vanceb/xbee-sensor/README.md

# xbee-sensor
Solar/battery powered sensor that uses XBee radios for communication
