vanceb/xbee-sensor/kicad/xbee-sensor_V2.0_BOM.ods

Id | Designator | Package | Quantity | Designation | In Stock
1 | C1,C2 | C_0805_2012Metric | 2 | 4.7uF | Y
2 | C3,C7,C8,C9 | C_0603_1608Metric | 4 | 100nF | Y
3 | C4,C12 | C_0805_2012Metric | 2 | 10uF | Y
4 | C5,C6 | C_0805_2012Metric | 2 | 1uF | Y
5 | C10,C11 | C_0402_1005Metric | 2 | 10pF | Y
6 | D1,D2,D3,D4,D5,D6,D7 | LED_0603_1608Metric | 7 | LED | Y
7 | J1 | PinHeader_1x02_P2.54mm_Vertical | 1 | Solar | Y
8 | J2 | PinHeader_2x03_P2.54mm_Vertical | 1 | SWD | Y
9 | J3 | PinHeader_1x04_P2.54mm_Vertical | 1 | I2C | Y
10 | J4 | JST_PH_S2B-PH-K_1x02_P2.00mm_Horizontal | 1 | Battery | Y
11 | J5 | PinHeader_1x03_P2.54mm_Vertical | 1 | PIR | Y
12 | Q1,Q2 | SOT-23 | 2 | NX2301P | Y
13 | Q3 | SOT-23 | 1 | SI2333DDS | Y
14 | R1,R2,R4,R5 | R_0603_1608Metric | 4 | 100k | Y
15 | R3 | R_0603_1608Metric | 1 | 2k | Y
16 | R6,R7 | R_0603_1608Metric | 2 | 10k | Y
17 | R8,R9,R10,R11,R12,R13,R14 | R_0603_1608Metric | 7 | 1k | Y
18 | U1 | SOT-223-3_TabPin2 | 1 | LD1117S33TR_SOT223 | Y
19 | U2 | SOT-23-5 | 1 | MCP73831-2-OT | 3
20 | U3 | XBee | 1 | XBee_Module_TH | 3
21 | U4 | LQFP-32_7x7mm_P0.8mm | 1 | STM32L031K6Tx | 3
22 | U5 | Allegro_SIP-3 | 1 | A3213 | 3
23 | Y1 | Crystal_SMD_3215-2Pin_3.2x1.5mm | 1 | Crystal | 3
24 | REF**,REF**,REF**,REF** | MountingHole_3.2mm_M3_ISO14580 | 4 | MountingHole_3.2mm_M3_ISO14580
25 | JP1 | PinHeader_1x02_P2.54mm_Vertical | 1 | LED_EN | Y
