vanceb/xbee-sensor/kicad/xbee-sensor-bom.ods

Item | Qty | Reference(s) | Value | LibPart
1 | 2 | C1, C2 | 4.7uF | Device:C
2 | 4 | C3, C7, C8, C9 | 100nF | Device:C
3 | 1 | C4 | 10uF | Device:C
4 | 2 | C5, C6 | 1uF | Device:C
5 | 2 | C10, C11 | 10pF | Device:C
6 | 1 | J1 | Solar | Connector_Generic:Conn_01x02
7 | 1 | J2 | I2C | Connector_Generic:Conn_01x04
8 | 1 | J3 | Battery | Connector_Generic:Conn_01x02
9 | 1 | J4 | PIR | Connector_Generic:Conn_01x03
10 | 1 | J5 | SWD | Connector_Generic:Conn_02x03_Odd_Even
11 | 2 | Q1, Q2 | NX2301P | Transistor_FET:TP0610T
12 | 4 | R1, R2, R4, R5 | 100k | Device:R
13 | 1 | R3 | 2k | Device:R
14 | 2 | R6, R7 | 10k | Device:R
15 | 1 | SW1 | RESET | Switch:SW_Push
16 | 1 | SW2 | BOOT0 | Switch:SW_Push
17 | 1 | U1 | LD1117S33TR_SOT223 | Regulator_Linear:LD1117S33TR_SOT223
18 | 1 | U2 | MCP73831-2-OT | Battery_Management:MCP73831-2-OT
19 | 1 | U3 | XBee_Module_TH | XBee:XBee_Module_TH
20 | 1 | U4 | STM32L031K6Tx | MCU_ST_STM32L0:STM32L031K6Tx
21 | 1 | U5 | A3213EUA-T | Sensor_Magnetic:A1101ELHL
22 | 1 | Y1 | Crystal | Device:Crystal
