vanceb/xbee-sensor/kicad/xbee-sensor.kicad_pcb

## KiCad design kicad/xbee-sensor.kicad_pcb (2019-06-30)

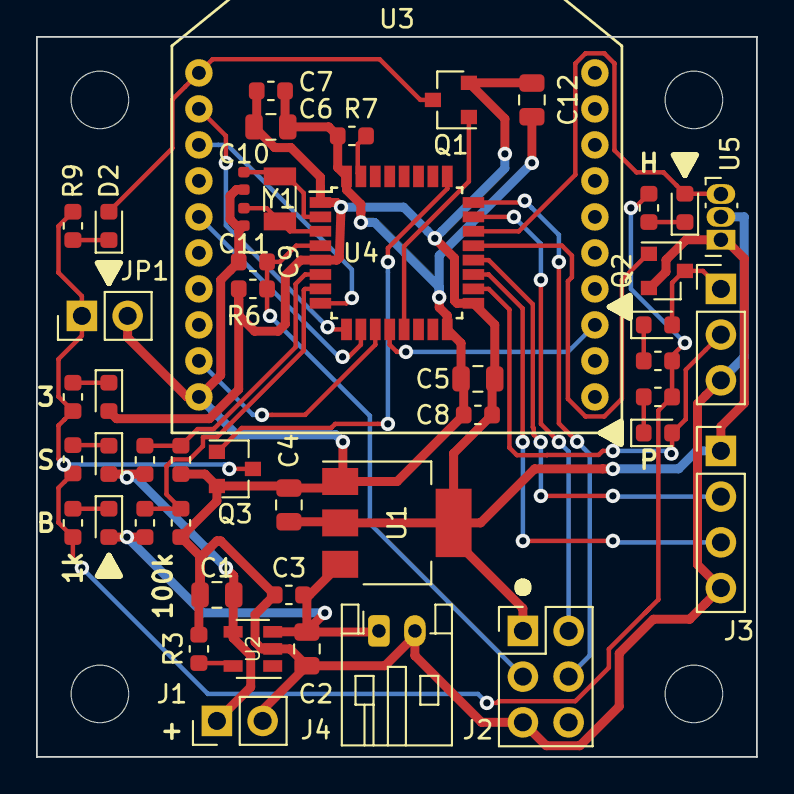
[picture p1: board xbee-sensor.kicad_pcb from above]

Board: 2 copper layers, 40.0 x 40.0 mm, 48 parts (0 on the bottom side), 35 nets.

Parts:
C1, C2: 4.7uF; C_0805_2012Metric
C3, C7, C8, C9: 100nF; C_0603_1608Metric
C4, C12: 10uF; C_0805_2012Metric
C5, C6: 1uF; C_0805_2012Metric
C10, C11: 10pF; C_0402_1005Metric
D1, D2, D3, D4, D5, D6, D7: LED; LED_0603_1608Metric
J1: Solar; PinHeader_1x02_P2.54mm_Vertical
J2: SWD; PinHeader_2x03_P2.54mm_Vertical
J3: I2C; PinHeader_1x04_P2.54mm_Vertical
J4: Battery; JST_PH_S2B-PH-K_1x02_P2.00mm_Horizontal
J5: PIR; PinHeader_1x03_P2.54mm_Vertical
JP1: LED_EN; PinHeader_1x02_P2.54mm_Vertical
Q1, Q2: NX2301P; SOT-23
Q3: SI2333DDS; SOT-23
R1, R2, R4, R5: 100k; R_0603_1608Metric
R3: 2k; R_0603_1608Metric
R6, R7: 10k; R_0603_1608Metric
R8, R9, R10, R11, R12, R13, R14: 1k; R_0603_1608Metric
U1: LD1117S33TR_SOT223; SOT-223-3_TabPin2
U2: MCP73831-2-OT; SOT-23-5
U3: XBee_Module_TH; XBee
U4: STM32L031K6Tx; LQFP-32_7x7mm_P0.8mm
U5: A3213; Allegro_SIP-3
Y1: Crystal; Crystal_SMD_3215-2Pin_3.2x1.5mm

Connections:
+3V3: C4.1, C5.1, C6.1, C7.1, C8.1, C12.2, D7.2, J2.1, J3.1, Q1.2, Q2.2, R6.1, U1.2, U4.1, U4.5, U4.17, U5.1
BATTERY: C2.1, C3.1, D6.2, J4.1, R4.1, U1.3, U2.3
BATTERY_SENSE: R4.2, R5.1, U4.7
BOOT0: R7.1, U4.31
EN_PIR: Q2.1, U4.21
EN_XBEE: Q1.1, U4.13
GND: C1.2, C2.2, C3.2, C4.2, C5.2, C6.2, C7.2, C8.2, C9.1, C10.1, C11.2, C12.1, J1.2, J2.5, J3.4, J4.2, J5.3, JP1.2, Q3.2, R2.2, R3.2, R5.2, R7.2, U1.1, U2.2, U3.10, U4.16, U4.32, U5.2
HALL: D3.2, U4.22, U5.3
I2C_SCL: J3.3, U4.19
I2C_SDA: J3.2, U4.20
LED_GND: JP1.1, Q3.3, R8.2, R9.2, R10.2, R11.2, R12.2, R13.2, R14.2
NRST: C9.2, J2.3, R6.2, U4.4
unnamed: C10.2, U4.2, Y1.2
unnamed: C11.1, U4.3, Y1.1
unnamed: D1.1, R8.1
unnamed: D2.1, R9.1
unnamed: D3.1, R10.1
unnamed: D4.1, R11.1
unnamed: D5.1, R12.1
unnamed: D6.1, R13.1
unnamed: D7.1, R14.1
unnamed: R3.1, U2.5
PIR: D4.2, J5.2, U4.18
PIR_PWR: D1.2, J5.1, Q2.3
SOLAR: C1.1, D5.2, J1.1, R1.1, U2.4
SOLAR_SENSE: R1.2, R2.1, U4.6
SWCLK: J2.4, U4.24
SWDIO: J2.2, U4.23
XBEE_PWR: D2.2, Q1.3, U3.1
XB_ON: U3.13, U4.12
XB_RESET: U3.5, U4.10
XB_RX: U3.2, U4.9
XB_SLEEP_REQ: U3.9, U4.11
XB_TX: U3.3, U4.8
~LED_EN: Q3.1, U4.25
