vanceb/xbee-sensor/STM32Cube/Src/main.c

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

/* Includes ------------------------------------------------------------------*/
#include "main.h"

/* USER CODE BEGIN Includes */
#include "SEGGER_RTT.h"
#include "ssd1306_i2c.h"
#include "ssd1306_fonts.h"

/* USER CODE END Includes */

ADC_HandleTypeDef hadc;
DMA_HandleTypeDef hdma_adc;

I2C_HandleTypeDef hi2c1;

RTC_HandleTypeDef hrtc;

UART_HandleTypeDef huart2;

/* USER CODE BEGIN PV */
uint16_t ADC_raw[4];
/* USER CODE END PV */

void SystemClock_Config(void);
static void MX_GPIO_Init(void);
static void MX_DMA_Init(void);
static void MX_ADC_Init(void);
static void MX_I2C1_Init(void);
static void MX_RTC_Init(void);
static void MX_USART2_UART_Init(void);
/* USER CODE BEGIN 0 */
void scan_I2C(I2C_HandleTypeDef *hi2c)
{
  SEGGER_RTT_printf(0, "Starting I2C Scan...\n");
  for (int i=0; i<127; i++) {
    if ((HAL_I2C_IsDeviceReady(hi2c, (uint8_t)(i<<1), 1, 2)) == HAL_OK) {
      SEGGER_RTT_printf(0, "Response from 0x%2X\n", i);
    }
  }
  SEGGER_RTT_printf(0, "Finished I2C Scan\n");
}

void xbee_on(void)
{
  SEGGER_RTT_printf(0, "Turning XBee Radio on\n");
  /* Turn on the power to the module */
  HAL_GPIO_WritePin(XB_EN_GPIO_Port, XB_EN_Pin, GPIO_PIN_RESET);
  /* Set the NOT_RESET pin - resets on logic 0 */
  HAL_GPIO_WritePin(XB_RESET_GPIO_Port, XB_RESET_Pin, GPIO_PIN_SET);
  /* Do not request sleep - Pin_Sleep (Pin 9) requires SM=1 in configuration of the module */
  HAL_GPIO_WritePin(XB_SLEEP_REQ_GPIO_Port, XB_SLEEP_REQ_Pin, GPIO_PIN_RESET);
}

/* USER CODE END 0 */

/**
  * @brief  The application entry point.
  * @retval int
  */
int main(void)
{
  

  /* MCU Configuration--------------------------------------------------------*/

  /* Reset of all peripherals, Initializes the Flash interface and the Systick. */
  HAL_Init();

  /* Configure the system clock */
  SystemClock_Config();

  /* Initialize all configured peripherals */
  MX_GPIO_Init();
  MX_DMA_Init();
  MX_ADC_Init();
  MX_I2C1_Init();
  MX_RTC_Init();
  MX_USART2_UART_Init();
  /* USER CODE BEGIN 2 */

  /* Initialise global variables */
  for (int i=0; i<4; i++){
    ADC_raw[i] = 0;
  }

  scan_I2C(&hi2c1);

  xbee_on();

  /* Test SSD1306 */
  ssd1306_Init();
  ssd1306_Fill(Black);
  ssd1306_SetCursor(2, 0);
  ssd1306_WriteString("Vance is Ace", Font_11x18, White);
  ssd1306_UpdateScreen();

  /* USER CODE END 2 */

  /* Infinite loop */
  /* USER CODE BEGIN WHILE */
  int i = 0;
  uint8_t hall = 0;
  uint8_t pir = 0;
  uint8_t is_asleep = 0;

  while (1)
  {
    /* Start ADC conversion using DMA */
    HAL_ADC_Start_DMA(&hadc, (uint32_t*) ADC_raw, 4);
    /* Read digital pins */
    hall = HAL_GPIO_ReadPin(HALL_GPIO_Port, HALL_Pin);
    pir = HAL_GPIO_ReadPin(PIR_GPIO_Port, PIR_Pin);
    is_asleep = HAL_GPIO_ReadPin(XB_ON_GPIO_Port, XB_ON_Pin);
    
    /* Print debug to segger */
    SEGGER_RTT_printf(0, "%d: XBee - %d  Hall - %d   PIR - %d  Solar - %d  Battery - %d   Ref - %d   Temp - %d\n", i, is_asleep, hall, pir, ADC_raw[0], ADC_raw[1], ADC_raw[2], ADC_raw[3]);

    if (i++ % 5 == 0)
    {
      SEGGER_RTT_printf(0, "Toggling PIR Pin\n");
      HAL_GPIO_TogglePin(EN_PIR_GPIO_Port, EN_PIR_Pin);
    }

    /* Hang out */
    HAL_Delay(5000);
    /* USER CODE END WHILE */

    /* USER CODE BEGIN 3 */
  }
  /* USER CODE END 3 */
}

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
