vanceb/xbee-sensor/STM32Cube/STM32CubePIO.ioc

Mcu.UserName=STM32L031K6Tx
PA0-CK_IN.GPIO_Label=SOLAR_SENSE
PA0-CK_IN.Signal=ADC_IN0
PA1.GPIO_Label=BATTERY_SENSE
PA1.Signal=ADC_IN1
PA10.Signal=I2C1_SDA
PA11.GPIO_Label=EN_PIR
PA11.Signal=GPIO_Output
PA12.GPIO_Label=HALL
PA12.Signal=GPIO_Input
PA13.Signal=SYS_SWDIO
PA14.Signal=SYS_SWCLK
PA15.GPIO_Label=LED_EN
PA15.Signal=GPIO_Output
PA2.GPIO_Label=XB_TX
PA2.Signal=USART2_TX
PA3.GPIO_Label=XB_RX
PA3.Signal=USART2_RX
PA4.GPIO_Label=XB_RESET
PA4.Signal=GPIO_Output
PA5.GPIO_Label=XB_SLEEP_REQ
PA5.Signal=GPIO_Output
PA6.GPIO_Label=XB_ON
PA6.Signal=GPIO_Input
PA7.GPIO_Label=XB_EN
PA7.Signal=GPIO_Output
PA8.GPIO_Label=PIR
PA8.Signal=GPIO_Input
PA9.Signal=I2C1_SCL
PC14-OSC32_IN.Signal=RCC_OSC32_IN
PC15-OSC32_OUT.Signal=RCC_OSC32_OUT
