vanceb/xbee-sensor/(commit log)

2019-02-12 Commit before V2 revisions
    [_saved_xbee-sensor.sch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]
2019-02-13 Version 2.0 layout
    [_saved_xbee-sensor.sch, xbee-sensor.kicad_pcb, xbee-sensor.sch]
2019-06-30 Created V2 ready for manufacture
    [xbee-sensor-B.Cu.gbl, xbee-sensor-B.Mask.gbs, xbee-sensor-B.Paste.gbp, xbee-sensor-B.SilkS.gbo, xbee-sensor-Edge.Cuts.gm1, xbee-sensor-F.Cu.gtl, xbee-sensor-F.Mask.gts, xbee-sensor-F.Paste.gtp]
2019-08-24 Version 2.0 boards
    [xbee-sensor_V2.0_BOM.ods]
2019-08-24 Testing vscode and I2C display
2019-11-05 Corrected case sensitivity caused by move to linux from OSX
    [main.c]
