vanceb/xbee-sensor/(notices)

Notices in the files:
STM32Cube/Src/main.c:
COPYRIGHT(c) 2019 STMicroelectronics
(C) COPYRIGHT STMicroelectronics *****END OF FILE
